Tejesh-ECM/Automated-Pill-Dispenser/ATTRIBUTION.md

# Sources and attribution

Based on MakersUPV, Smart Pill Dispenser: https://www.hackster.io/makersupv/smart-pill-dispenser-07a43f

Original and adapted mechanical materials retain Creative Commons Attribution NonCommercial 4.0 terms: https://creativecommons.org/licenses/by-nc/4.0/ . The source assembly STEP is preserved in mechanical/original_sources. Extracted parts are in mechanical/reference_parts, and experimental rotor adaptations are in mechanical/pill_candidates. The rotor adaptations replace the original Rueda edge opening while retaining its central geometry. These changes have not been endorsed by the original authors.

The desktop app, Arduino firmware, calibration helper, engineering drawings and build documentation in this redesign were created for this project. Third-party Arduino and Python libraries retain their respective licences and are installed separately, not relicensed by this package. Pinning a dependency version is a reproducibility choice, not a claim that the library author verified this dispenser.

Use the budget revision's docs/WIRING.md and docs/ACCEPTANCE_TESTS.md for current assignments and limitations. The original assembly is a source reference, not the final budget assembly.
