Tejesh-ECM/Automated-Pill-Dispenser/mechanical/budget_candidates/shared_refill_guard.stl

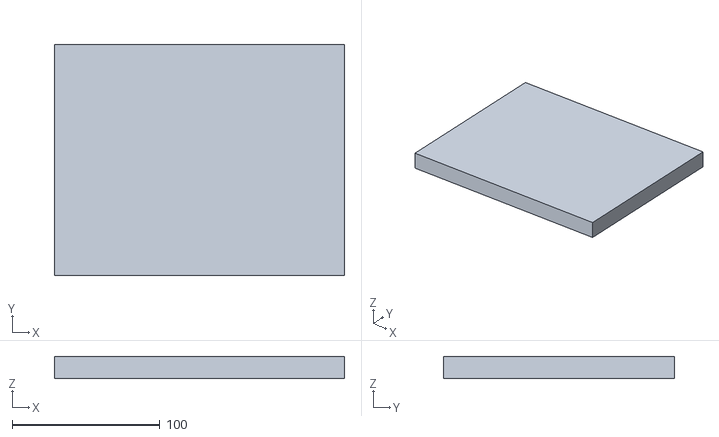
[picture p1: CAD file, 2026-10-11]
mechanical/budget_candidates/shared_refill_guard.stl
196.0 x 156.0 x 15.0
