Tejesh-ECM/Automated-Pill-Dispenser/mechanical/pill_candidates/C4_capsule_rotor.step

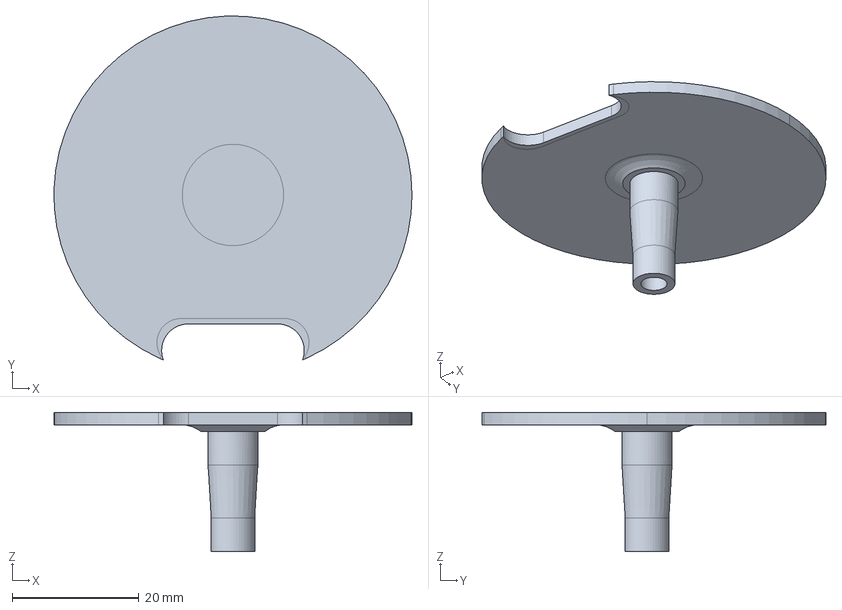
[picture p2: CAD file, 2026-10-11]
mechanical/pill_candidates/C4_capsule_rotor.step
56.5 x 54.3 x 22.0 mm
