Tejesh-ECM/Automated-Pill-Dispenser/mechanical/reference_parts/SmartPill_Drawings_v4_Slider_Slider_End.step

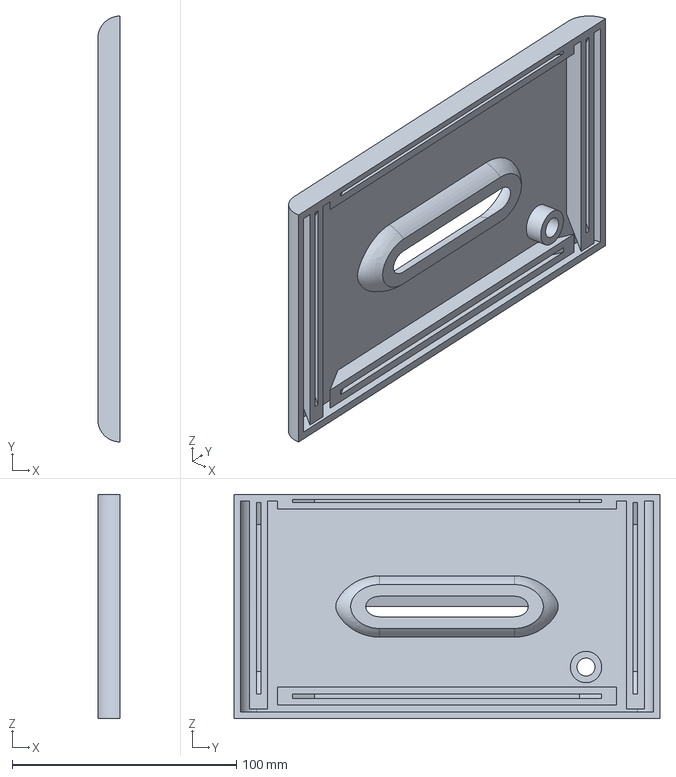
[picture p3: CAD file, 2026-10-11]
mechanical/reference_parts/SmartPill_Drawings_v4_Slider_Slider_End.step
10.0 x 190.0 x 100.0 mm
