Tejesh-ECM/Automated-Pill-Dispenser/mechanical/budget_candidates/lcd_16x2_plate.stl

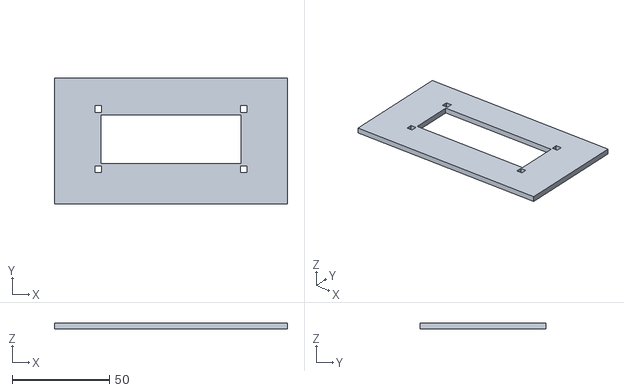
[picture p4: CAD file, 2026-10-11]
mechanical/budget_candidates/lcd_16x2_plate.stl
120.0 x 65.0 x 3.00
