Tejesh-ECM/Automated-Pill-Dispenser/mechanical/pill_candidates/C2_large_round_rotor.step

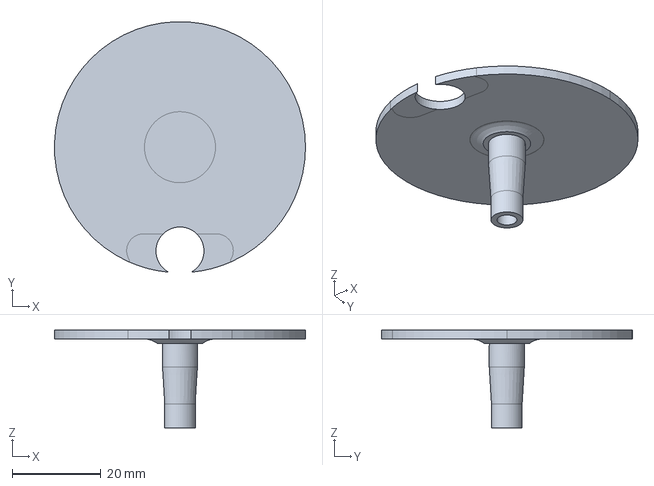
[picture p5: CAD file, 2026-10-11]
mechanical/pill_candidates/C2_large_round_rotor.step
56.5 x 56.4 x 22.0 mm
