Tejesh-ECM/Automated-Pill-Dispenser/mechanical/reference_parts/SmartPill_Drawings_v4_Back_Door.step

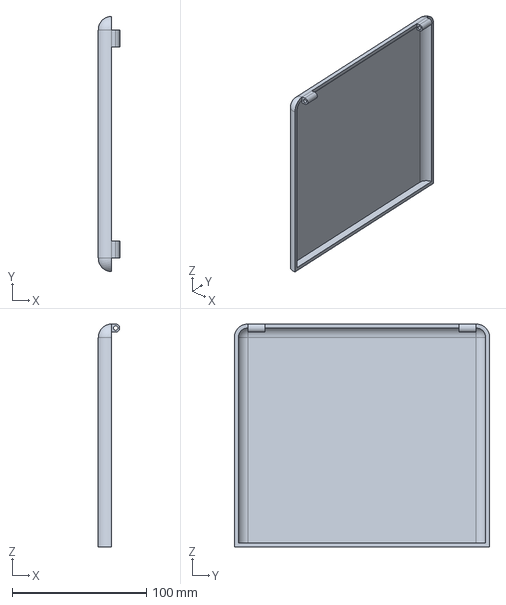
[picture p6: CAD file, 2026-10-11]
mechanical/reference_parts/SmartPill_Drawings_v4_Back_Door.step
16.0 x 190.0 x 165.9 mm
