Tejesh-ECM/Automated-Pill-Dispenser/mechanical/budget_candidates/fixed_receiving_tray.stl

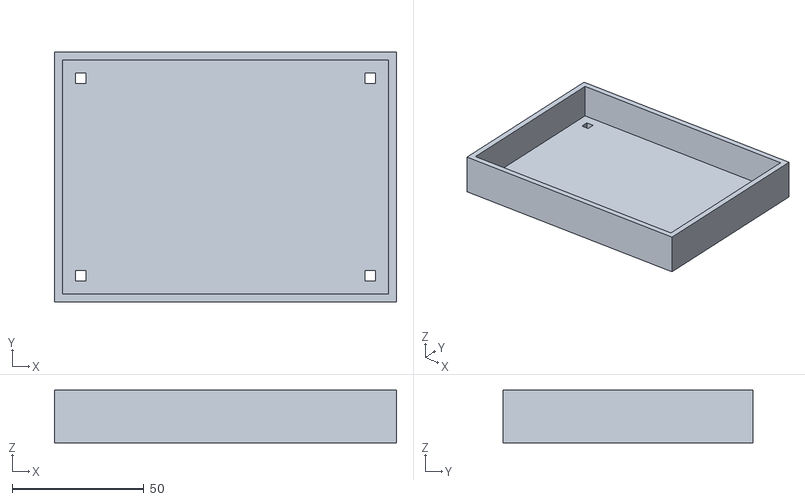
[picture p7: CAD file, 2026-10-11]
mechanical/budget_candidates/fixed_receiving_tray.stl
130.0 x 95.0 x 20.0
