Tejesh-ECM/Automated-Pill-Dispenser/mechanical/reference_parts/SmartPill_Drawings_v4_Slider_Slider_bottom.step

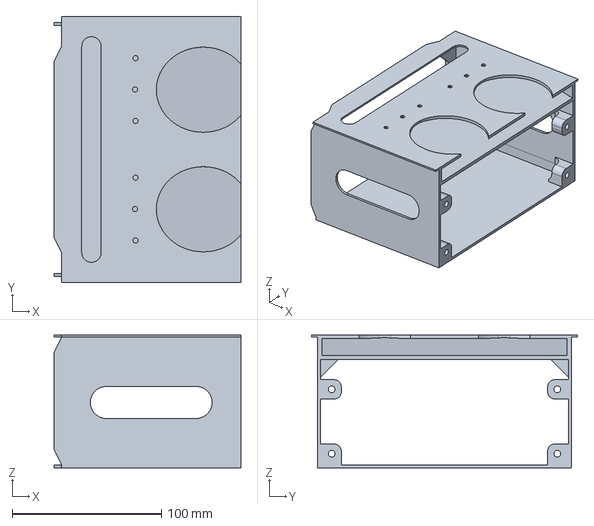
[picture p9: CAD file, 2026-10-11]
mechanical/reference_parts/SmartPill_Drawings_v4_Slider_Slider_bottom.step
125.0 x 178.0 x 88.8 mm
