Tejesh-ECM/Automated-Pill-Dispenser/mechanical/budget_candidates/manual_refill_plate.stl

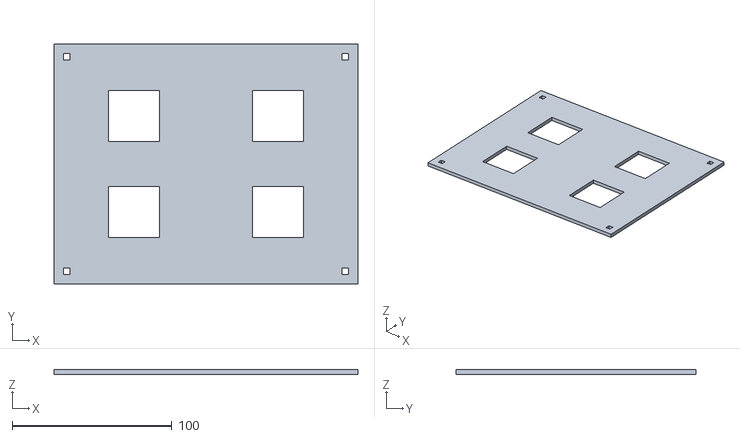
[picture p10: CAD file, 2026-10-11]
mechanical/budget_candidates/manual_refill_plate.stl
190.0 x 150.0 x 3.00
