Tejesh-ECM/Automated-Pill-Dispenser/mechanical/pill_candidates/C4_capsule_clearance_coupon.step

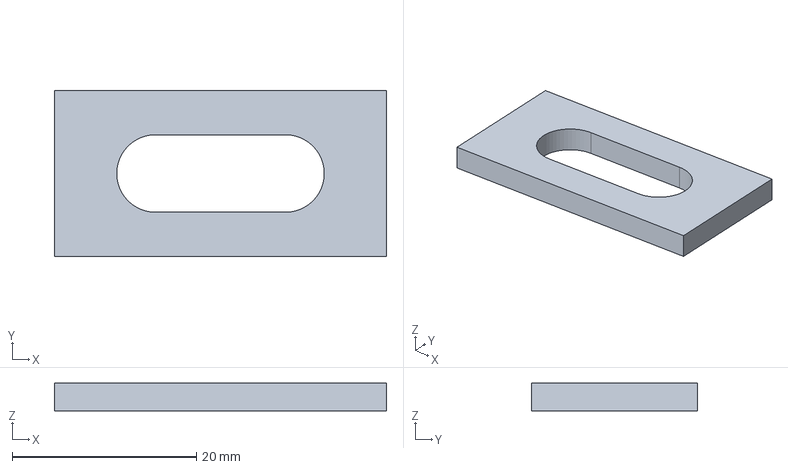
[picture p11: CAD file, 2026-10-11]
mechanical/pill_candidates/C4_capsule_clearance_coupon.step
36.0 x 18.0 x 3.00 mm
