Tejesh-ECM/Automated-Pill-Dispenser/mechanical/reference_parts/SmartPill_Drawings_v4_Dispensers_Dispenser_v9_Servo_Housing_Body1.step

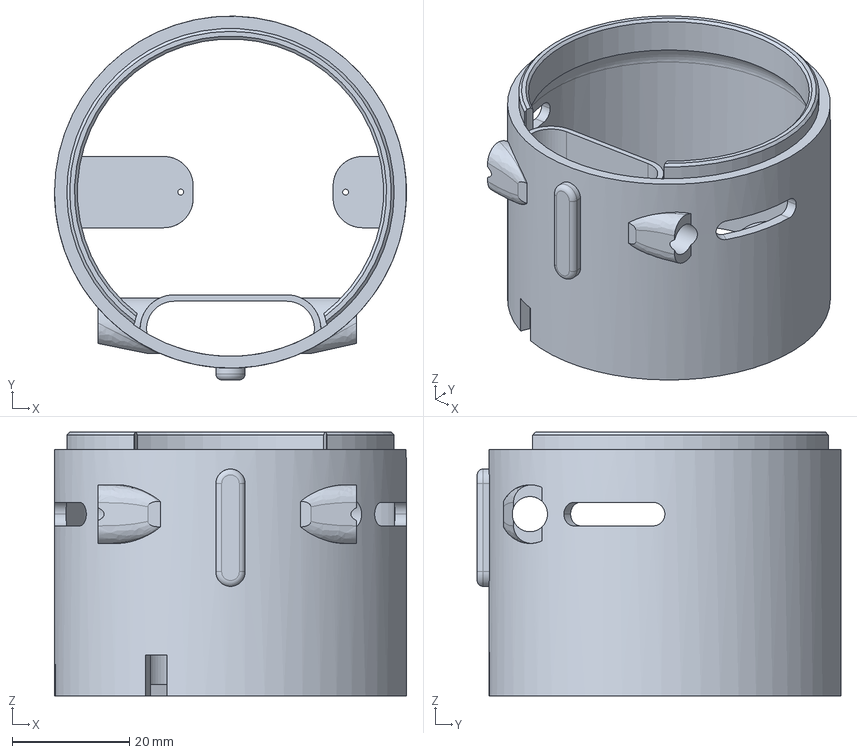
[picture p12: CAD file, 2026-10-11]
mechanical/reference_parts/SmartPill_Drawings_v4_Dispensers_Dispenser_v9_Servo_Housing_Body1.step
60.0 x 62.0 x 45.0 mm
