Tejesh-ECM/Automated-Pill-Dispenser/mechanical/budget_candidates/cover_switch_bracket.stl

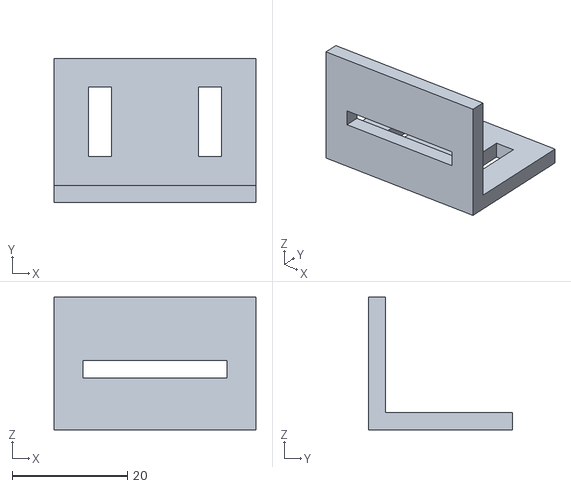
[picture p13: CAD file, 2026-10-11]
mechanical/budget_candidates/cover_switch_bracket.stl
35.0 x 25.0 x 23.0
