Tejesh-ECM/Automated-Pill-Dispenser/mechanical/pill_candidates/C1_small_round_rotor.step

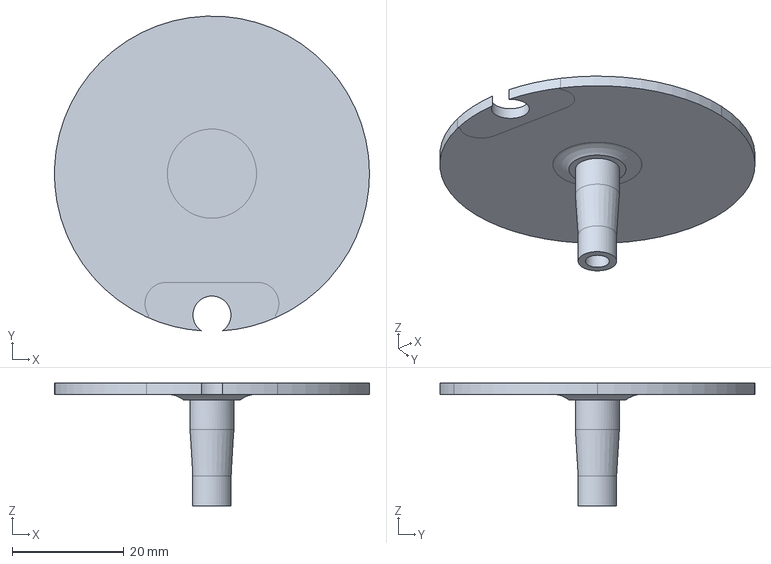
[picture p14: CAD file, 2026-10-11]
mechanical/pill_candidates/C1_small_round_rotor.step
56.5 x 56.4 x 22.0 mm
