Tejesh-ECM/Automated-Pill-Dispenser/mechanical/reference_parts/SmartPill_Drawings_v4_Drum.step

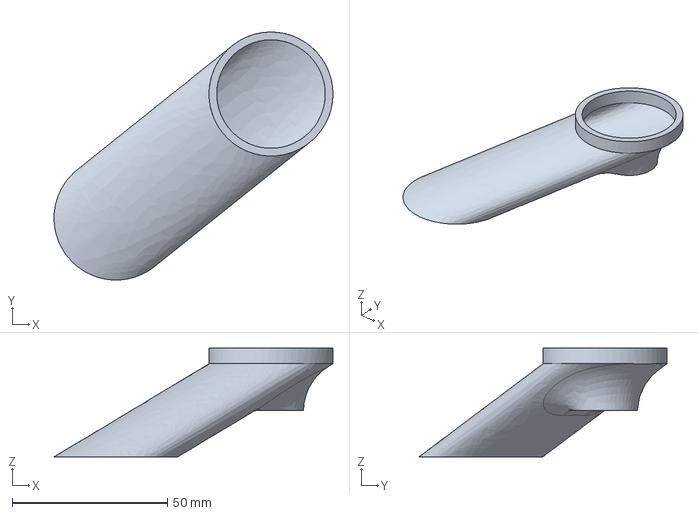
[picture p15: CAD file, 2026-10-11]
mechanical/reference_parts/SmartPill_Drawings_v4_Drum.step
90.0 x 80.0 x 35.0 mm
