Tejesh-ECM/Automated-Pill-Dispenser/mechanical/budget_candidates/refill_cap_print_four.stl

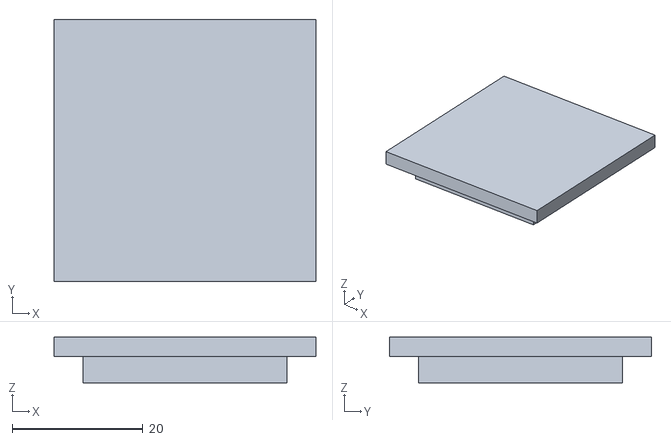
[picture p16: CAD file, 2026-10-11]
mechanical/budget_candidates/refill_cap_print_four.stl
40.0 x 40.0 x 7.00
