Tejesh-ECM/Automated-Pill-Dispenser/mechanical/pill_candidates/C1_small_round_dummy.step

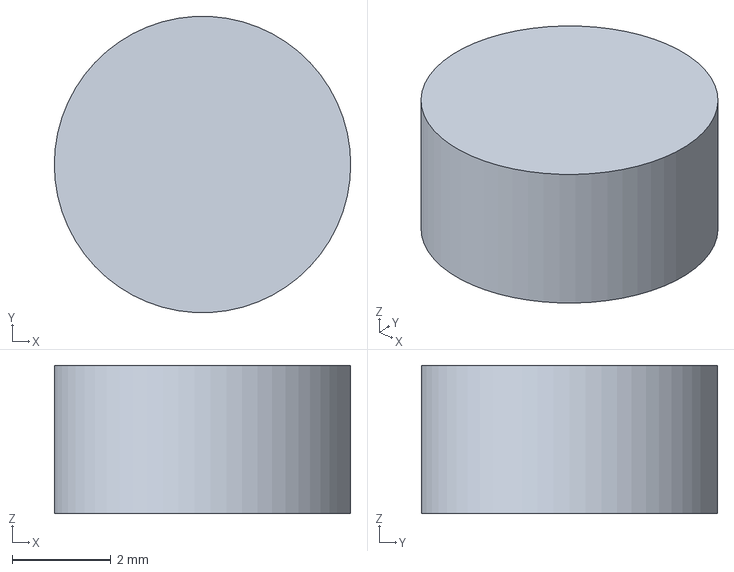
[picture p17: CAD file, 2026-10-11]
mechanical/pill_candidates/C1_small_round_dummy.step
6.00 x 5.99 x 3.00 mm
