Tejesh-ECM/Automated-Pill-Dispenser/mechanical/reference_parts/SmartPill_Drawings_v4_Dispensers_Dispenser_Base.step

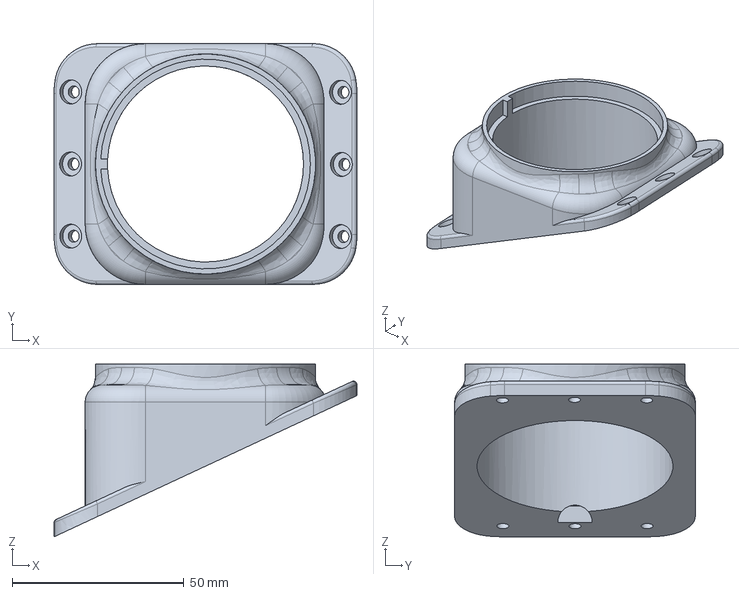
[picture p18: CAD file, 2026-10-11]
mechanical/reference_parts/SmartPill_Drawings_v4_Dispensers_Dispenser_Base.step
88.1 x 70.0 x 50.2 mm
