Tejesh-ECM/Automated-Pill-Dispenser/mechanical/budget_candidates/controller_plate.stl

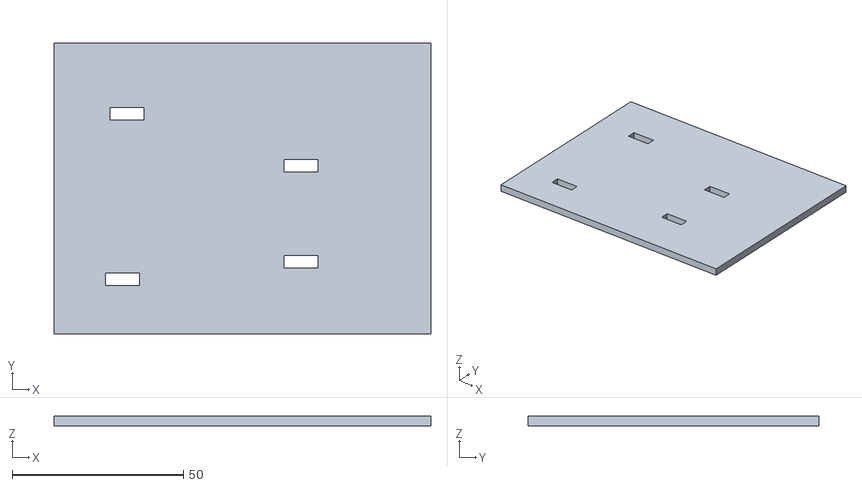
[picture p19: CAD file, 2026-10-11]
mechanical/budget_candidates/controller_plate.stl
110.0 x 85.0 x 3.00
