Tejesh-ECM/Automated-Pill-Dispenser/mechanical/pill_candidates/C3_oblong_dummy.step

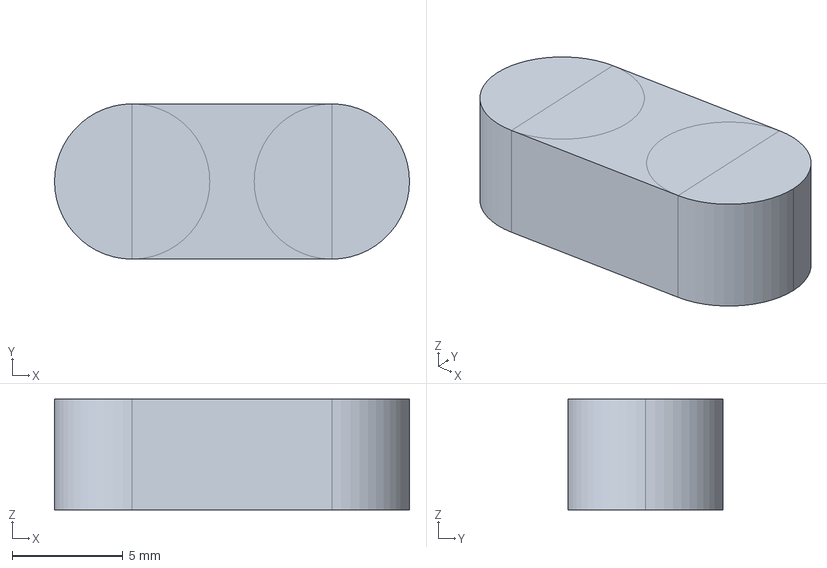
[picture p20: CAD file, 2026-10-11]
mechanical/pill_candidates/C3_oblong_dummy.step
16.0 x 7.00 x 5.00 mm
