Tejesh-ECM/Automated-Pill-Dispenser/mechanical/reference_parts/SmartPill_Drawings_v4_Mid_Display_holder.step

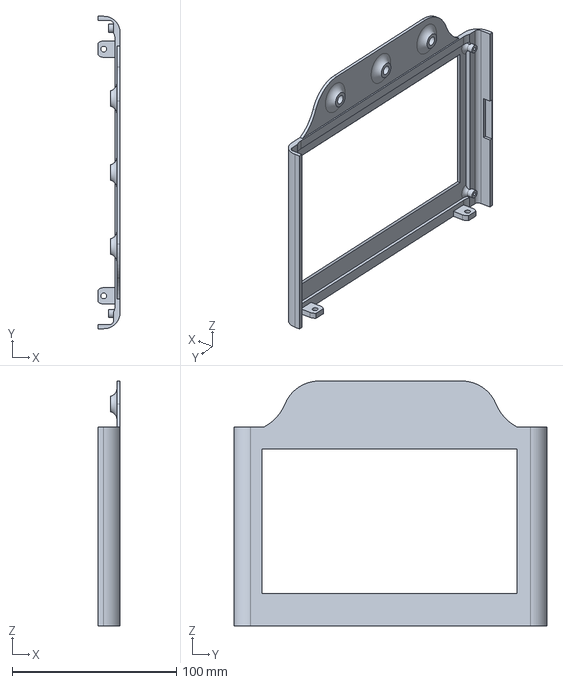
[picture p21: CAD file, 2026-10-11]
mechanical/reference_parts/SmartPill_Drawings_v4_Mid_Display_holder.step
13.6 x 190.0 x 148.9 mm
