Tejesh-ECM/Automated-Pill-Dispenser/mechanical/budget_candidates/refill_led_tab_print_four.stl

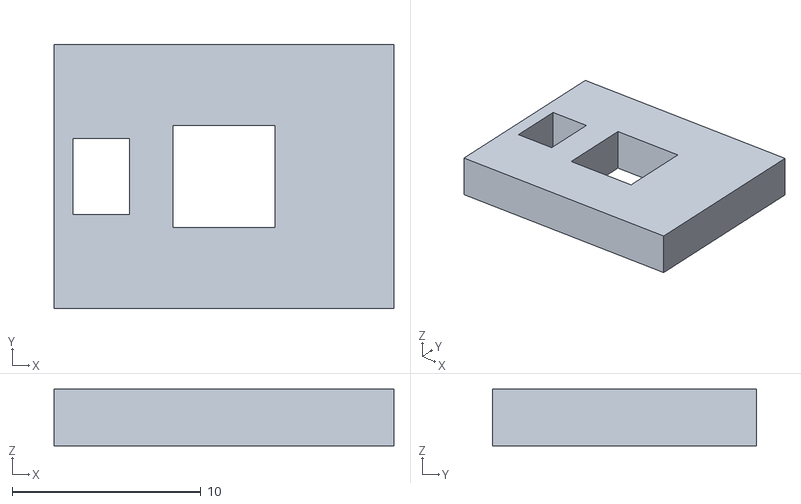
[picture p22: CAD file, 2026-10-11]
mechanical/budget_candidates/refill_led_tab_print_four.stl
18.0 x 14.0 x 3.00
