Tejesh-ECM/Automated-Pill-Dispenser/mechanical/reference_parts/SmartPill_Drawings_v4_Dispensers_Dispenser_v9_Cuenco.step

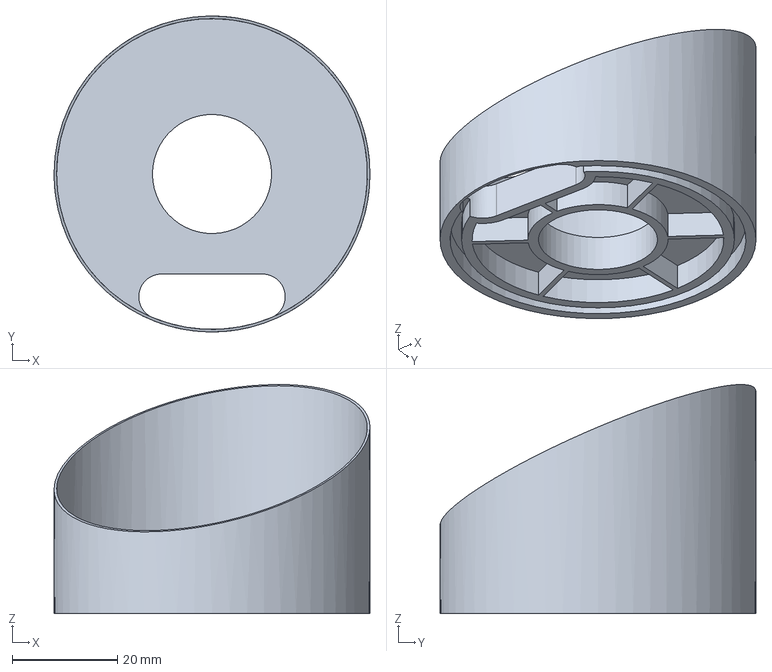
[picture p23: CAD file, 2026-10-11]
mechanical/reference_parts/SmartPill_Drawings_v4_Dispensers_Dispenser_v9_Cuenco.step
60.0 x 60.0 x 43.5 mm
