Tejesh-ECM/Automated-Pill-Dispenser/mechanical/pill_candidates/C2_large_round_dummy.step

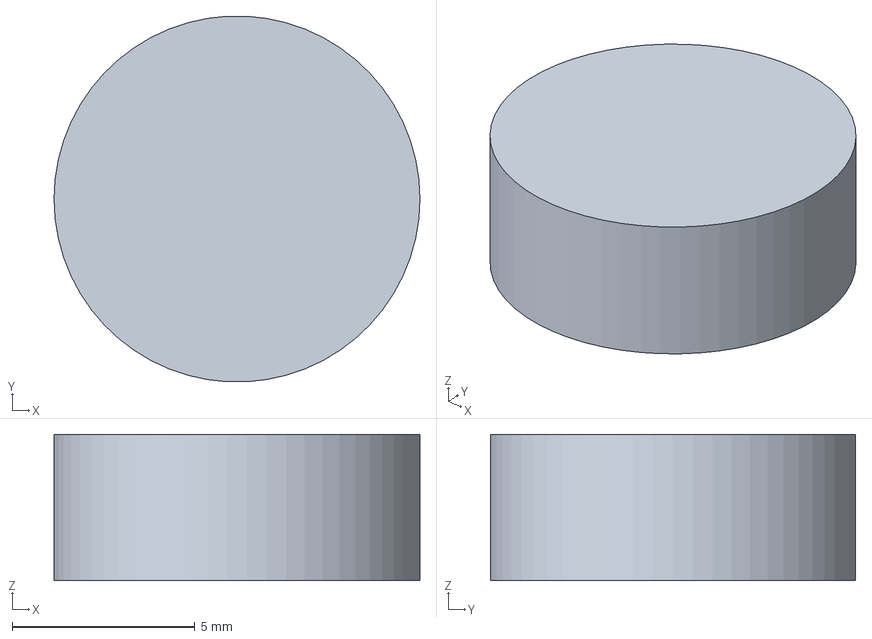
[picture p24: CAD file, 2026-10-11]
mechanical/pill_candidates/C2_large_round_dummy.step
10.0 x 9.99 x 4.00 mm
