Tejesh-ECM/Automated-Pill-Dispenser/mechanical/pill_candidates/C3_oblong_rotor.step

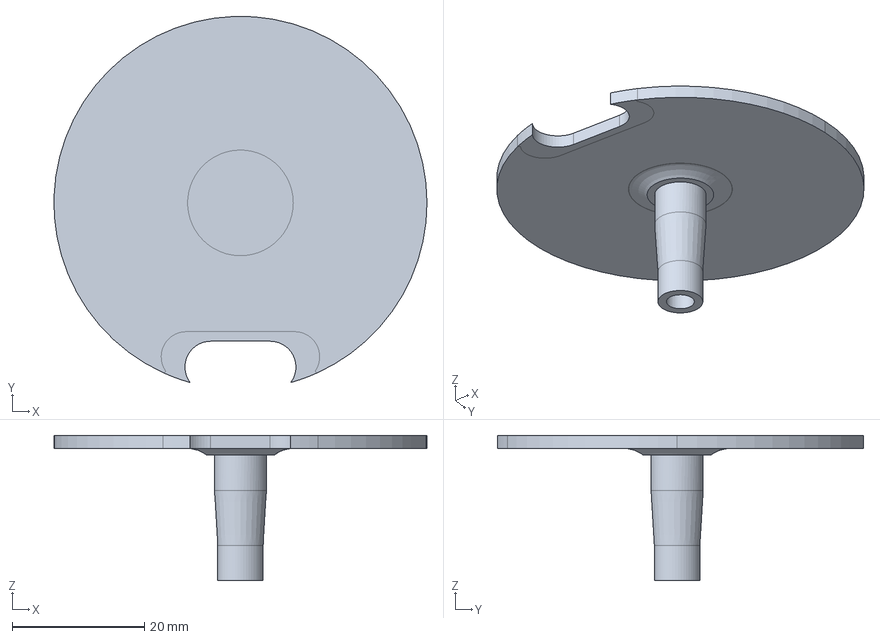
[picture p26: CAD file, 2026-10-11]
mechanical/pill_candidates/C3_oblong_rotor.step
56.5 x 55.4 x 22.0 mm
