Tejesh-ECM/Automated-Pill-Dispenser/mechanical/reference_parts/SmartPill_Drawings_v4_Base.step

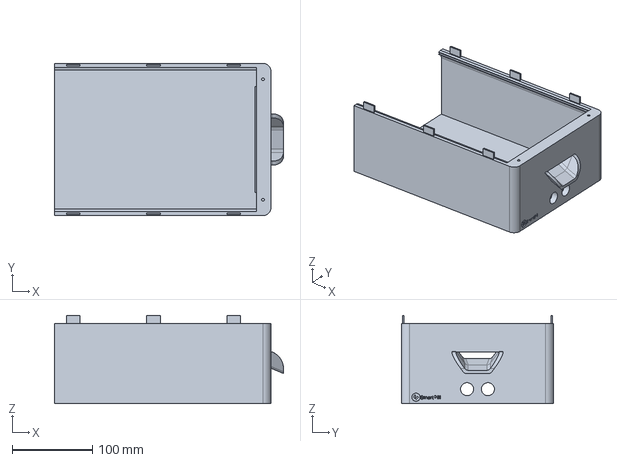
[picture p27: CAD file, 2026-10-11]
mechanical/reference_parts/SmartPill_Drawings_v4_Base.step
285.6 x 190.0 x 110.0 mm
