Tejesh-ECM/Automated-Pill-Dispenser/mechanical/pill_candidates/C1_small_round_clearance_coupon.step

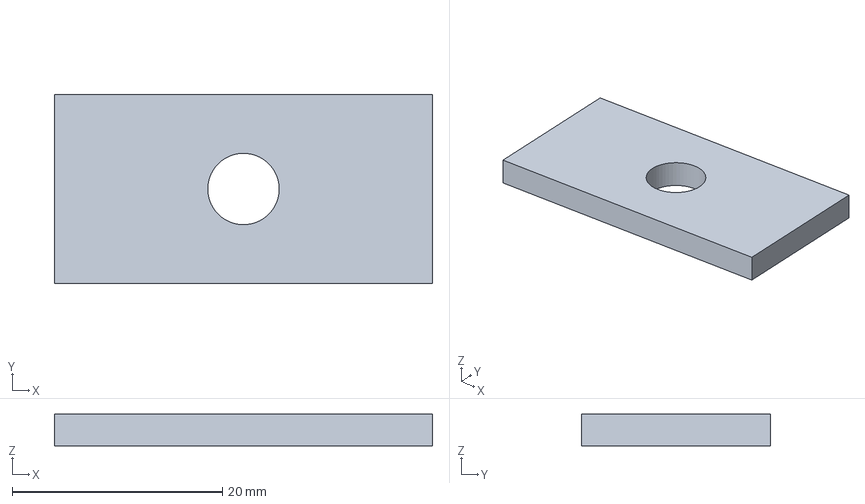
[picture p28: CAD file, 2026-10-11]
mechanical/pill_candidates/C1_small_round_clearance_coupon.step
36.0 x 18.0 x 3.00 mm
