Tejesh-ECM/Automated-Pill-Dispenser/mechanical/reference_parts/SmartPill_Drawings_v4_Mid_Right_Wall.step

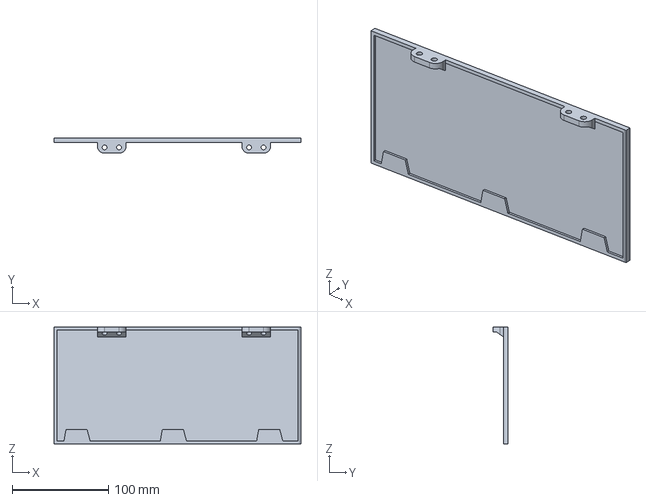
[picture p29: CAD file, 2026-10-11]
mechanical/reference_parts/SmartPill_Drawings_v4_Mid_Right_Wall.step
256.4 x 16.0 x 120.9 mm
