Tejesh-ECM/Automated-Pill-Dispenser/mechanical/pill_candidates/C4_capsule_dummy.step

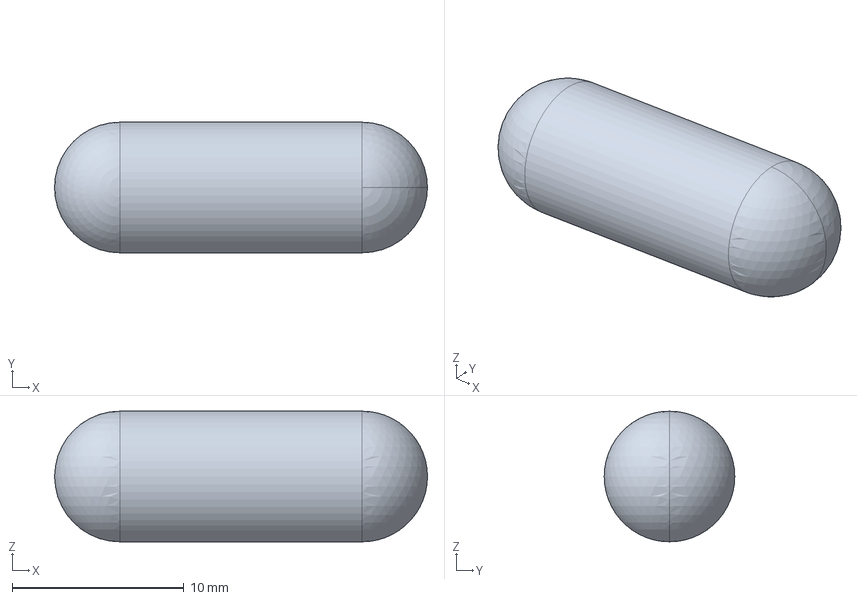
[picture p30: CAD file, 2026-10-11]
mechanical/pill_candidates/C4_capsule_dummy.step
21.7 x 7.60 x 7.60 mm
