Tejesh-ECM/Automated-Pill-Dispenser/mechanical/reference_parts/SmartPill_Drawings_v4_Top_Top_cover.step

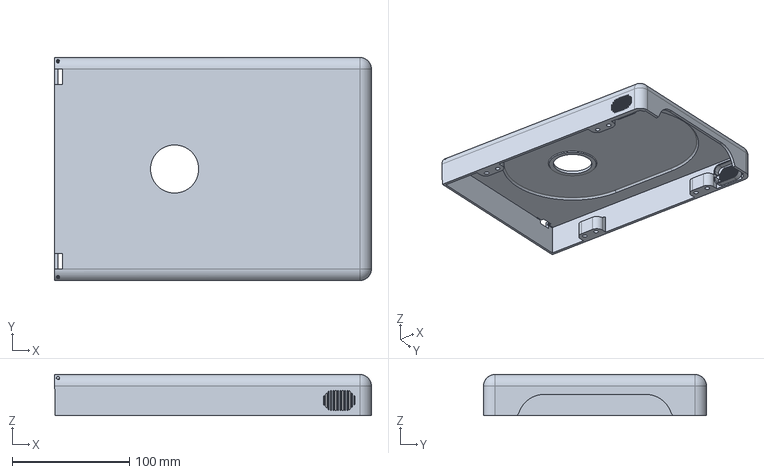
[picture p32: CAD file, 2026-10-11]
mechanical/reference_parts/SmartPill_Drawings_v4_Top_Top_cover.step
270.0 x 190.0 x 35.0 mm
