Tejesh-ECM/Automated-Pill-Dispenser/mechanical/reference_parts/SmartPill_Drawings_v4_Dispensers_Dispenser_v9_Servo_Housing_Body6.step

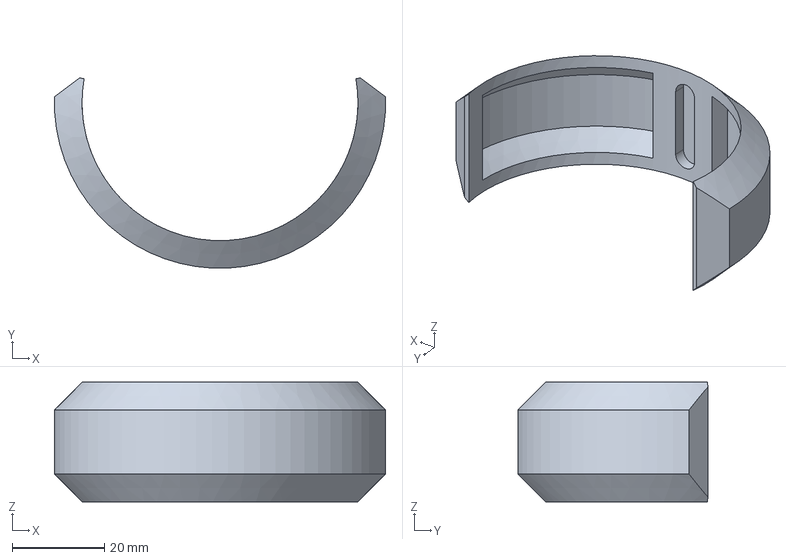
[picture p33: CAD file, 2026-10-11]
mechanical/reference_parts/SmartPill_Drawings_v4_Dispensers_Dispenser_v9_Servo_Housing_Body6.step
72.0 x 41.3 x 26.0 mm
