Tejesh-ECM/Automated-Pill-Dispenser/mechanical/budget_candidates/controller_plate.scad

// TEMPLATE ONLY. Measure and edit before printing. Millimetres.
difference(){union(){
translate([0, 0, 0]) cube([110, 85, 3]);
}
translate([15, 14.2, -1]) cube([10, 3.6000000000000014, 5]);
translate([16.3, 62.5, -1]) cube([10.0, 3.5999999999999943, 5]);
translate([67.1, 19.3, -1]) cube([10.0, 3.6000000000000014, 5]);
translate([67.1, 47.300000000000004, -1]) cube([10.0, 3.5999999999999943, 5]);
}
