Tejesh-ECM/Automated-Pill-Dispenser/mechanical/budget_candidates/cover_switch_bracket.scad

// TEMPLATE ONLY. Measure and edit before printing. Millimetres.
difference(){union(){
translate([0, 0, 0]) cube([35, 25, 3]);
translate([0, 0, 3]) cube([35, 3, 20]);
}
translate([6, 8, -1]) cube([4, 12, 5]);
translate([25, 8, -1]) cube([4, 12, 5]);
translate([5, -1, 9]) cube([25, 5, 3]);
}
