Tejesh-ECM/Automated-Pill-Dispenser/mechanical/budget_candidates/fixed_receiving_tray.scad

// TEMPLATE ONLY. Measure and edit before printing. Millimetres.
difference(){union(){
translate([0, 0, 0]) cube([130, 95, 20]);
}
translate([3, 3, 3]) cube([124, 89, 18]);
translate([8, 8, -1]) cube([4, 4, 4.1]);
translate([118, 8, -1]) cube([4, 4, 4.1]);
translate([8, 83, -1]) cube([4, 4, 4.1]);
translate([118, 83, -1]) cube([4, 4, 4.1]);
}
