Tejesh-ECM/Automated-Pill-Dispenser/mechanical/budget_candidates/lcd_16x2_plate.scad

// TEMPLATE ONLY. Measure and edit before printing. Millimetres.
difference(){union(){
translate([0, 0, 0]) cube([120, 65, 3]);
}
translate([24, 21, -1]) cube([72, 25, 5]);
translate([20.8, 16.3, -1]) cube([3.3999999999999986, 3.3999999999999986, 5]);
translate([95.8, 16.3, -1]) cube([3.4000000000000057, 3.3999999999999986, 5]);
translate([20.8, 47.3, -1]) cube([3.3999999999999986, 3.4000000000000057, 5]);
translate([95.8, 47.3, -1]) cube([3.4000000000000057, 3.4000000000000057, 5]);
}
