Tejesh-ECM/Automated-Pill-Dispenser/mechanical/budget_candidates/manual_refill_plate.scad

// TEMPLATE ONLY. Measure and edit before printing. Millimetres.
difference(){union(){
translate([0, 0, 0]) cube([190, 150, 3]);
}
translate([34, 29, -1]) cube([32, 32, 5]);
translate([124, 29, -1]) cube([32, 32, 5]);
translate([34, 89, -1]) cube([32, 32, 5]);
translate([124, 89, -1]) cube([32, 32, 5]);
translate([6, 6, -1]) cube([4, 4, 5]);
translate([180, 6, -1]) cube([4, 4, 5]);
translate([6, 140, -1]) cube([4, 4, 5]);
translate([180, 140, -1]) cube([4, 4, 5]);
}
