Tejesh-ECM/Automated-Pill-Dispenser/mechanical/budget_candidates/refill_cap_print_four.scad

// TEMPLATE ONLY. Measure and edit before printing. Millimetres.
difference(){union(){
translate([0, 0, 0]) cube([40, 40, 3]);
translate([4.4, 4.4, -4]) cube([31.200000000000003, 31.200000000000003, 4]);
}

}
