Tejesh-ECM/Automated-Pill-Dispenser/mechanical/budget_candidates/refill_led_tab_print_four.scad

// TEMPLATE ONLY. Measure and edit before printing. Millimetres.
difference(){union(){
translate([0, 0, 0]) cube([18, 14, 3]);
}
translate([6.3, 4.3, -1]) cube([5.3999999999999995, 5.3999999999999995, 5]);
translate([1, 5, -1]) cube([3, 4, 5]);
}
