Tejesh-ECM/Automated-Pill-Dispenser/(list of files, cad)

Other CAD files:
mechanical/pill_candidates/C3_oblong_clearance_coupon.step
mechanical/reference_parts/SmartPill_Drawings_v4_Dispensers_Dispenser_v9_Rueda.step
mechanical/budget_candidates/shared_refill_guard.scad
mechanical/pill_candidates/C1_small_round_clearance_coupon.stl
mechanical/pill_candidates/C1_small_round_dummy.stl
mechanical/pill_candidates/C1_small_round_rotor.stl
mechanical/pill_candidates/C2_large_round_clearance_coupon.stl
mechanical/pill_candidates/C2_large_round_dummy.stl
mechanical/pill_candidates/C2_large_round_rotor.stl
mechanical/pill_candidates/C3_oblong_clearance_coupon.stl
mechanical/pill_candidates/C3_oblong_dummy.stl
mechanical/pill_candidates/C3_oblong_rotor.stl
mechanical/pill_candidates/C4_capsule_clearance_coupon.stl
mechanical/pill_candidates/C4_capsule_dummy.stl
mechanical/pill_candidates/C4_capsule_rotor.stl
mechanical/reference_parts/SmartPill_Drawings_v4_Back_Door.stl
mechanical/reference_parts/SmartPill_Drawings_v4_Base.stl
mechanical/reference_parts/SmartPill_Drawings_v4_Dispensers_Dispenser_Base.stl
mechanical/reference_parts/SmartPill_Drawings_v4_Dispensers_Dispenser_v9_Cuenco.stl
mechanical/reference_parts/SmartPill_Drawings_v4_Dispensers_Dispenser_v9_Rueda.stl
mechanical/reference_parts/SmartPill_Drawings_v4_Dispensers_Dispenser_v9_Servo_Housing_Body1.stl
mechanical/reference_parts/SmartPill_Drawings_v4_Dispensers_Dispenser_v9_Servo_Housing_Body6.stl
mechanical/reference_parts/SmartPill_Drawings_v4_Drum.stl
mechanical/reference_parts/SmartPill_Drawings_v4_Mid_Display_holder.stl
mechanical/reference_parts/SmartPill_Drawings_v4_Mid_Left_Wall.stl
mechanical/reference_parts/SmartPill_Drawings_v4_Mid_Right_Wall.stl
mechanical/reference_parts/SmartPill_Drawings_v4_Slider_Slider_End.stl
mechanical/reference_parts/SmartPill_Drawings_v4_Slider_Slider_Face.stl
mechanical/reference_parts/SmartPill_Drawings_v4_Slider_Slider_bottom.stl
mechanical/reference_parts/SmartPill_Drawings_v4_Top_Top_base.stl
mechanical/reference_parts/SmartPill_Drawings_v4_Top_Top_cover.stl
