Tejesh-ECM/Automated-Pill-Dispenser/SmartPill_Complete_Audited_Guide.docx

# SmartPill Complete Project Guide

Audited budget revision with guided refill LEDs

UNO R4 Minima or UNO R4 WiFi • Protocol 4 • Chennai cost planning • 9 October 2026

Four containers dispense whole test pieces at three saved daily times. The computer sets labels, quantities and times through USB. The controller then runs the schedule independently while external power remains connected.

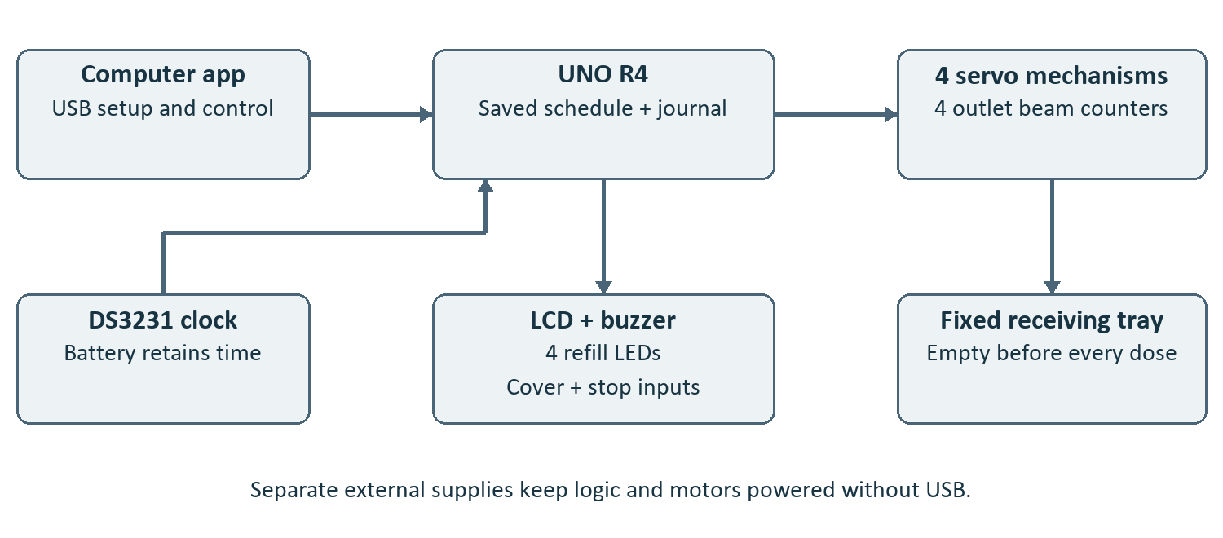
[picture p35: figure]

## Current project status

Firmware, desktop software, candidate CAD and instructions are supplied. This audit corrected software defects and passed the checks described on page 14. No physical board or assembled dispenser was connected during the audit. CAD fit, pill separation, servo torque, optical accuracy and power interruption behaviour still need bench testing.

Use inert objects during development. The shipped configuration keeps normal dispensing disabled until commissioning. This is a supervised college prototype, not a validated medication delivery device.

## Budget at a glance

Electronics allowance: ₹5,594. With ₹500–1,000 delivery and ₹1,000 reserve: ₹7,094–7,594. A practical electronics budget is about ₹7,500–8,000. Printing, mechanical hardware, liner, tools, computer and labour are additional.

## Guide map

2 Features • 3 Daily operation • 4 Refill • 5 Structures • 6 Pin map • 7 Circuits and power • 8–9 Materials and costs • 10 Assembly • 11 Software setup • 12 Acceptance tests • 13 Faults • 14 Audit • 15 Files and references

# Features and their exact behaviour

Feature | What it does and its limits
Four independent containers | Each holds one labelled type. A separate positional servo and optical outlet channel serve each container. Containers dispense sequentially.
Three daily periods | Three distinct times; each period has four quantities from 0 to 10 whole pieces. A zero quantity skips that container. Names are labels, not identification.
Computer independent schedule | Settings and daily claims live in internal data flash. A DS3231 supplies time. USB is unnecessary for scheduled dispensing after setup; both external supplies remain on.
No duplicate automatic replay | A date claim is committed before motion. Already claimed periods do not repeat on the same or an earlier date. Late or inhibited periods are skipped; there is no automatic catch-up.
Optical counting | Four conditioned IR beams count complete beam interruptions. Unexpected outlet activity, excess counts, blockage and timeouts latch faults. Two touching pieces may still look like one event.
16 by 2 LCD | Shows date/time, next configured time, disabled state, selected refill label/number, count progress and a shortened fault. Read the software for longer detail.
Buzzer | Three short beeps at dose start, two on completion and five on fault. It is a passive piezo with a transistor driver.
Wired computer app | Connect, set local clock, edit/read/save settings, enable controls, view LCD/result, select refill LED, request an extra manual dose, stop and clear an inspected fault.
Selected refill LED | Exactly one of four LEDs lights after a valid connected-software selection. All others stay off. It does not detect medicine, level or successful filling.
Cover and physical stop | Open cover inhibits refill-time motion; opening it during motion faults. A separate stop contact cuts motor power and another contact signals the controller.
Fault recovery and storage | An unfinished recorded job requires inspection after restart. CRC-checked snapshots rotate across eight 1 KB pages. Torn storage is not silently accepted.
Limited result record | The latest device outcome survives offline. Connected result snapshots are logged on the computer. Neither collection nor medicine intake is confirmed.

No inventory, remaining-pill estimate, prescription calculation, automatic refill confirmation or full offline event history is implemented. The simple design does not infer these from optical counts.

# Daily operation and scheduling

## Before each scheduled dose

1. Check that the physical container labels match the saved software labels and that the saved quantities are correct.

2. Empty the fixed tray and fit its cleanable liner. A later dose will join any pieces left there; the machine cannot detect this.

3. Close every refill cap and the shared cover. Release the physical stop. Confirm the LCD shows enabled operation and the correct local clock.

4. Keep the 9 V logic adapter and 5 V motor adapter powered. The computer can be unplugged after setup.

## What happens at a due time

After startup settles, the scheduler checks the RTC about once per second. When a saved period is due and the device is ready, it saves that period’s date claim, then an active-job record, before attaching a servo. It drives the required containers one at a time and counts their outlet events.

At the requested count, the servo is commanded closed and held for 500 ms. It is then detached before proceeding. On success the active marker clears, DISPENSED is stored, the buzzer sounds twice and the unit returns to IDLE. The gate must stay physically closed without servo holding torque.

Situation | Result
Computer disconnected | Saved automatic schedules continue. Manual jobs depend on computer heartbeats and fault after the configured timeout.
Power completely lost | No dispensing occurs. The coin cell keeps only the clock running. An unfinished recorded job faults on restart.
Due time while busy, refilling or disabled | That period is skipped and claimed for the day. Closing the cover or finishing another job does not intentionally catch it up.
Power restored after a period’s minute | That period is missed. Restoration during the due minute may dispense if no prior claim exists and startup checks pass.
Manual dose requested | It is an EXTRA dose using the selected period’s saved quantities. It does not replace or consume the automatic period.
Clock moved backwards | A period already claimed for a date cannot repeat on that date or an earlier one. Check settings after any clock change.

The saved schedule checkbox and “Enable controls” serve different purposes: the checkbox enables automatic periods; controls must also be armed. Clearing a fault leaves controls disabled until explicitly enabled. Normal commissioned startup can arm automatically after checks pass.

# Guided refill procedure

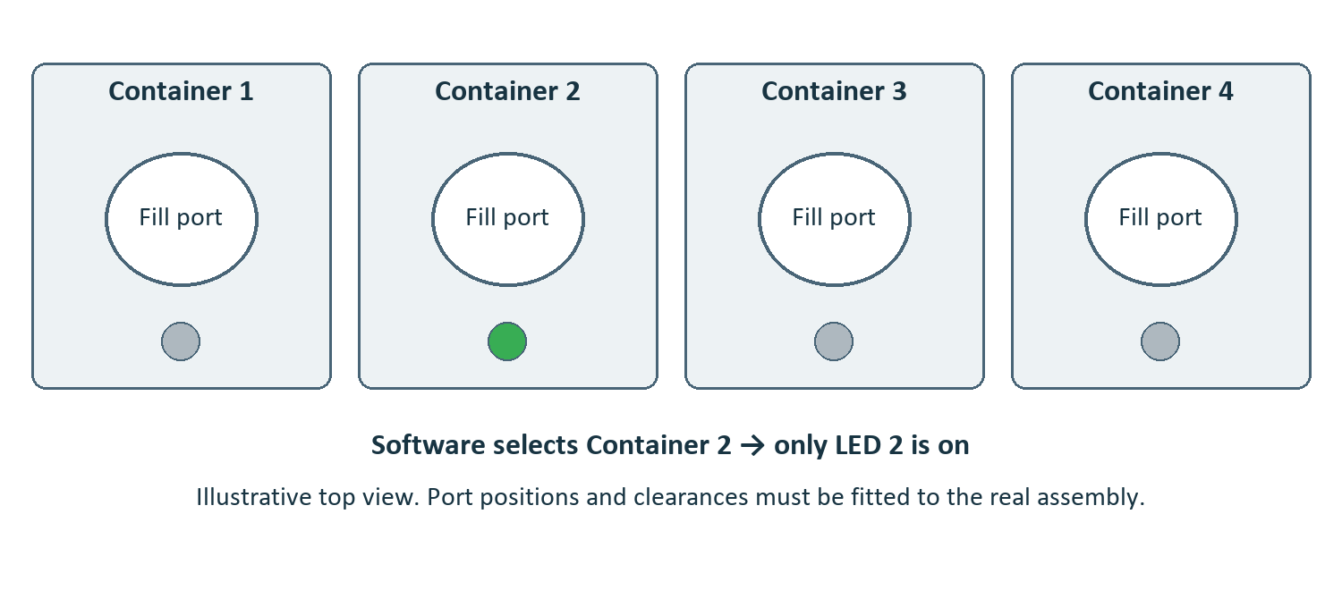
[picture p36: figure]

1. Wait for IDLE, plug in USB and connect the computer app. Read saved settings so container numbers and medicine labels are current.

2. Choose the required container in the Refill guide selector. Click “Light selected container” and wait for confirmation from the device. Only that container’s LED lights; the LCD shows its saved label and number.

3. Open the shared cover. Open only the selected container’s cap. Check the printed label against the intended contents, then fill without pressing pieces into the rotor or exceeding a physically tested fill level.

4. Close that cap. To refill another container, select it in software; the previous LED turns off before the new one turns on.

5. Close every cap and the shared cover. After one second of stable closure, refill mode ends and all LEDs switch off. “Finish refill” also works with the cover safely closed.

6. Check the tray for any stray pieces, inspect the LCD and verify the next scheduled time. A period missed during refill is not replayed.

## Meaning of the light

The LED means “this is the selected port to refill.” It stays lit during selection, including before medicine is added. The system cannot know whether that container was actually filled. Do not describe it as a refill-complete or pill-level sensor.

## If the computer connection is lost

LEDs clear when disconnect is detected, or within the five-second heartbeat timeout. An open cover continues to inhibit motion. Closing the app sends a cancellation when possible. With no USB connection, manual refill remains possible using the printed labels and cover interlock, without LED guidance.

Opening the cover during dispensing is a fault, not a normal refill request. Stop, inspect the tray and mechanism, and use the recovery procedure on page 13.

# Mechanical structure and CAD status

The proposed assembly has four original-style bowl/rotor dispensing mechanisms, four direct fill ports with caps, a shared guard, a fixed tray, a smaller LCD panel and an UNO mounting plate. LEDs mount beside the fixed ports, outside the pill paths; do not put wiring on removable caps.

Included structure | Status and work still required
Original bowl, rotor and motor housing references | Available in mechanical/reference_parts and the full STEP source. The original motor housing is labelled for TGY-9025MG; SG90 mounting and shaft fit are unverified.
Manual refill plate and four caps | Editable templates. Plate 190 × 150 × 3 mm; example 32 mm square ports at (50,45), (140,45), (50,105), (140,105) mm. These are not assembly-derived coordinates.
Shared guard and switch bracket | Templates need hinges/retention, clearances and switch travel fitted to the real assembly. Cover closure must be mechanically unambiguous.
LCD and controller plates | LCD plate 120 × 65 × 3 mm with a 72 × 25 mm window. Measure the purchased display, backpack and mounting holes before printing.
Fixed receiving tray | Candidate cradle/tray geometry; fit it under the real common outlet and verify maximum-dose capacity. Add a removable cleanable liner.
Four LED tabs | Print four: each template 18 × 14 × 3 mm with a 5.4 mm square aperture. Adapt LED retention and insulate exposed leads.

## Four test piece profiles

Container | Illustrative shape | Envelope in mm
1 | Small round tablet | 6 × 6 × 3
2 | Larger round tablet | 10 × 10 × 4
3 | Oblong tablet | 16 × 7 × 5
4 | Capsule shaped piece | 21.7 × 7.6 × 7.6

These are illustrative engineering test envelopes, not verified “most-used” pill sizes or a promise that all commercial pills fit. Measure actual length, width and thickness. Profile-shaped holes alone do not prevent stacked pieces or double feeds.

Eight new template meshes pass closure, orientation and volume checks. No complete assembled fit is proven. The original base is about 285.6 × 190 mm, beyond many 220 mm printer beds: use a suitable printer or engineer a split; do not scale the whole mechanism. Print one mechanism and fit coupons before committing all parts.

# Complete UNO R4 connection map

UNO R4 point | Connection | Important detail
USB-C | Computer data cable | Use a data cable; USB Serial is the app link.
Barrel jack | 9 V regulated adapter | Centre positive; 5.5 × 2.1 mm plug.
5 V logic rail | LCD, RTC, SN74HC14, optics, buzzer driver | Measure total load and regulator temperature.
A4 / SDA; A5 / SCL | LCD and DS3231 I2C bus | RTC 0x68; confirm LCD address before editing config.h.
D2; D3; D4; D5 | Servo signals 1; 2; 3; 4 | One 10 kΩ signal pull-down per servo.
D0; D1; D8; D12 | Conditioned optical outputs 1; 2; 3; 4 | Blocked must read LOW. Do not use Serial1.
A0; A1; A2; A3 | Refill LEDs 1; 2; 3; 4 | Each output → its own 1 kΩ resistor → LED anode.
D7 | Cover switch to GND | Closes only with cover fully fitted. INPUT_PULLUP.
D9 | Stop sense NC contact to GND | Released stop closes contact; stop/broken wire opens it.
D10 | 1 kΩ → buzzer transistor base | 10 kΩ from base to GND.
GND | Logic ground and motor negative | Join grounds at distribution; keep positive rails separate.

## Pin conflict corrected in this revision

A0–A3 are digital outputs for the four refill LEDs. They must not remain connected to raw phototransistor collector nodes. Keep those raw nodes only at the Schmitt inputs and insulated meter/scope pads. The actual digital beam signals stay on D0, D1, D8 and D12.

## Before applying power

- Use the correct board option: UNO R4 Minima for Minima, or UNO R4 WiFi for that board. The classic UNO R3 is not compatible with this build.
- Verify switch continuity in the real fitted/released positions; contact labels alone can be misleading.
- Do not run motor current through the UNO regulator, GPIO pins or a solderless breadboard.
- Keep logic and motor positives separate. Do not feed the motor adapter into the UNO 5 V pin or USB supply.

# Circuits and power distribution

## Optical channels and filtering

For each IR emitter: logic 5 V → initial 220 Ω resistor → emitter anode; cathode → GND. Check the purchased emitter current rating. Phototransistor emitter → GND; collector → raw node; 10 kΩ pulls the raw node to 5 V. The raw node feeds a Schmitt inverter.

SN74HC14N DIP14: pin 14 to 5 V, pin 7 to GND, 100 nF directly between them. Use input→output pairs 1→2, 3→4, 5→6 and 9→8 for channels 1–4. Tie unused inputs 11 and 13 to GND; leave outputs 10 and 12 open. Clear aligned beams should give HIGH at the UNO; blocked beams LOW. Shield paths from stray light and separate neighbouring channels.

## Refill LEDs and buzzer

A0–A3 each feed a separate 1 kΩ resistor and LED anode; each cathode returns to GND. Typical current is 2–3 mA; the 5 V/1 kΩ upper bound is 5 mA, below the R4 8 mA per-pin maximum. Never substitute the 220 Ω emitter resistor here.

Passive piezo positive → logic 5 V; negative → PN2222A collector; emitter → GND. Put a separate 1 kΩ discharge resistor across the piezo terminals (5 V to collector). D10 drives the base through another 1 kΩ, with a 10 kΩ base-to-GND pull-down. Check the actual transistor pin order. The discharge path is required for this capacitive piezo load; verify clear beeps on the bench.

## Two independent supplies

Motor path: enclosed regulated 5 V/5 A adapter → main fuse → adequately DC-rated normally closed stop power contact → four fused servo-positive branches. Each servo ground returns to the motor negative. Only one servo is commanded at a time, but all connected units may draw idle current.

Logic path: separate regulated 9 V/1 A adapter → UNO barrel jack. Common ground joins the systems; their positive outputs are not joined. Include a matching motor-adapter input socket in the harness allowance. The example motor plug is 5.5 × 2.5 mm, different from the UNO barrel size.

Initial fuse allowances are 5 A time-delay main and 2 A time-delay per branch. These are provisional: final values depend on measured inrush/stall current and the weakest wire, connector and contact rating. Starting wire sizes are 18 AWG trunk, 22 AWG motor branches and 24–26 AWG signals; verify drop and temperature.

Place the 1000 µF capacitor on the supply side of the stop contact. Use local 100 nF decoupling at the Schmitt IC and near sensor/LCD/RTC branches as needed. Keep wires short, insulated and strain relieved. The seven small capacitors are a purchasing allowance, not an instruction to fit unnecessary duplicates on already-decoupled modules.

## RTC battery and mechanical closure

Use a non-charging DS3231 breakout with a CR2032. Its battery powers only timekeeping. Detaching a servo or cutting power does not guarantee a closed gate: the mechanism itself must remain closed without holding torque. Exact stop selection, supply load and closure tests are required.

# Electronics materials and cost part one

Chennai planning estimate in INR, 9 October 2026. These are rounded allowances, not an order or guaranteed supplier quote. Quantities are for four containers. Only current installed electronics are listed.

Item | Qty | Each ₹ | Total ₹ | Use or purchasing check
UNO R4 Minima | 1 | 1000 | 1000 | Controller and internal schedule storage
16x2 LCD with I2C backpack | 1 | 250 | 250 | Clock, next time, status and faults
DS3231 module, non-charging battery circuit | 1 | 300 | 300 | Independent clock
CR2032 | 1 | 40 | 40 | Retains time during power loss
5 V-compatible SG90 positional servo | 4 | 150 | 600 | One per dispensing mechanism; verify torque
Matched IR emitter and phototransistor pair | 4 | 30 | 120 | Individual outlet counters
SN74HC14N DIP14 | 1 | 60 | 60 | Conditions optical signals
Passive piezo buzzer | 1 | 30 | 30 | Audible reminders and faults
PN2222A transistor | 1 | 10 | 10 | Buzzer driver
220 ohm resistors | 4 | 2 | 8 | Initial emitter current limiting
10 kohm resistors | 9 | 2 | 18 | 4 optical pull-ups, 4 servo signal pull-downs, 1 buzzer pull-down
1 kohm resistors | 6 | 2 | 12 | Buzzer base and piezo discharge resistors, plus four individual refill LED resistors
Diffused 5 mm green indicator LEDs | 4 | 5 | 20 | One beside each refill port; selected through USB software

The 1 kΩ quantity is six: four LED resistors, one buzzer base resistor and one resistor across the piezo for discharge. The nine 10 kΩ resistors are four optical pull-ups, four servo signal pull-downs and one buzzer base pull-down.

## Selection checks before buying

- Choose a genuine compatible UNO R4 board. An owned UNO R4 WiFi can run the matching build; the allowance assumes buying Minima.
- Buy an HD44780-compatible 16×2 character LCD with a compatible I2C backpack. Confirm the controller and address; supplier descriptions may be inconsistent.
- Buy positional servos, not continuous-rotation models. SG90 is a cost candidate only; check the actual unit’s 5 V rating, mounting, torque and reliable return to closure.
- Use matched IR emitter/phototransistor pairs with datasheets. Generic part names do not establish sensing distance or current ratings.

# Electronics materials and cost part two

Item | Qty | Each ₹ | Total ₹ | Use or purchasing check
100 nF capacitors | 7 | 3 | 21 | Decoupling allowance
1000 uF >=16 V electrolytic | 1 | 35 | 35 | Motor supply transient support, upstream of stop
Two-NC latching stop with adequate DC breaking capacity | 1 | 1000 | 1000 | Provisional allowance; exact rating/quote unresolved
Cover interlock microswitch and leads | 1 | 100 | 100 | Manual refill inhibit
Enclosed regulated 5 V 5 A adapter | 1 | 900 | 900 | Conditional on measured servo load test
9 V 1 A centre-positive 5.5x2.1 mm adapter | 1 | 250 | 250 | Independent UNO supply
Main fuse and holder | 1 | 80 | 80 | Initial 5 A time-delay; final rating by measurements
Branch fuse and holder | 4 | 60 | 240 | Initial 2 A time-delay per servo; verify ratings
USB-C data cable | 1 | 100 | 100 | Computer setup; reuse if available
Copper wire and DC input socket assortment | 1 | 300 | 300 | Rated soldered harness; include a socket matching the motor adapter plug
Perfboard and heat-shrink assortment | 1 | 100 | 100 | Insulated sensor/driver assembly and joints

Budget item | Amount
Installed electronics allowance | ₹5,594
Delivery allowance | ₹500–1,000
Spares, pack quantities and price variation reserve | ₹1,000
Combined planning range | ₹7,094–7,594
Practical electronics budget | About ₹7,500–8,000

Printing, mechanical hardware, cleanable liner, tools, laptop and labour are excluded. A reliable total build price requires a print quote and a finalized mechanical assembly. The exact stop contact is not selected; ₹1,000 is a placeholder, not proof that a suitable rated part is available at that price.

## Low cost choices without changing the objective

Reuse a compatible owned UNO R4 (₹1,000 allowance saved) and a suitable data cable (₹100 saved). Use the college printer and test instruments when available. Fit one container first to avoid four failed prints. Keep the current LCD, buzzer and refill LEDs: the LED addition is only ₹28; its four resistors are already included above.

Do not omit the RTC, optical counters, stop, cover interlock, current-limiting resistors or required power protection to meet this budget. The current design depends on them. Reusing a part avoids purchasing it; it does not remove its function.

# Assembly instructions and common mistakes

1. Measure the actual servo, horn, LCD, UNO, switch and adapter plugs. Record their dimensions before modifying the candidate CAD.

2. Build one empty bowl/rotor assembly. Confirm smooth motion, retained hardware and closure without power. Adapt its motor mount to the purchased servo; do not force an incompatible horn.

3. Fit one optical channel around its outlet. Check clear/blocked logic with motor power disconnected. Add light shielding and accessible insulated test pads.

4. Validate the first mechanism with inert test pieces before repeating it for the other three containers.

5. Fit four labelled fill ports and caps, a shared guard and the cover switch. Confirm each port opens into only its intended container. Check finger, wire and cap clearance.

6. Mount the fixed tray and liner under every outlet. Fit controller/LCD plates on insulated standoffs and mount the four labelled LEDs on fixed tabs.

7. Assemble the logic circuits on perfboard. Inspect polarity and resistor values, then continuity-test the ground and power rails before applying logic power.

8. Wire the fused motor distribution and two-contact stop. Leave motor positives disconnected while uploading factory firmware and checking all logic inputs.

9. Connect one fused motor branch for empty calibration, then add the remaining branches after measured acceptance. Route motor returns away from sensor wiring.

10. Complete the tests on page 12 and retain the measurement record with the project.

## Mistakes most likely to cause failure

Mistake | Prevention
Printing everything before a fit check | Print one mount/rotor and fit coupons first; revise the dimensions from measurements.
Leaving raw optics on A0–A3 | Move them to Schmitt inputs/test pads; these UNO pins now drive LEDs.
Using a chargeable RTC board with CR2032 | Choose a non-charging breakout or a properly documented compatible battery arrangement.
Treating NO/NC labels as installed behaviour | Measure continuity with the cover fitted and removed, and with the stop released and pressed.
Relying on servo detachment to close the outlet | Verify mechanical closure after power is removed; redesign a gate that drifts open.
Changing a fuse to stop nuisance trips | Measure current and find the cause before changing ratings; protect the weakest wiring/contact.

# Firmware and computer setup

## Install the firmware

1. Install Arduino Renesas UNO board package 1.6.0. Select the actual UNO R4 Minima or UNO R4 WiFi board and USB port.

2. Install Servo 1.3.0, RTClib 2.1.4, Adafruit BusIO 1.17.4, ArduinoJson 7.4.3 and hd44780 1.3.2. The pinned list is firmware/libraries.txt.

3. Open firmware/SmartPillBudget/SmartPillBudget.ino. Confirm the LCD I2C address in config.h; 0x27 is a default, and some backpacks use 0x3F.

4. Leave HARDWARE_COMMISSIONED=false for initial upload. OPEN_US/CLOSED_US and the 300 µs beam filter are starting values, not calibration results.

5. Complete logic checks and empty servo calibration. Set proven pulse/filter values. Enable HARDWARE_COMMISSIONED only for the supervised inert-object acceptance phase; distribute uncommissioned builds with it false.

## Install and use the simple Windows app

1. Install Python 3 with Tcl/Tk. Run Setup.bat to install pyserial 3.5, then Start.bat.

2. Choose the COM port and connect. The app checks SmartPillBudget protocol 4, then reads the device settings. Close Serial Monitor first so it does not own the same port.

3. Check the computer’s local date/time, then click Set clock. The device stores local wall time; Chennai should use IST. There is no automatic network time correction.

4. Enter four labels of at most 16 plain ASCII characters, three distinct HH:MM times and whole-piece counts 0–10. Check “Enable saved daily schedule” when ready.

5. Click Save to dispenser and wait for “Device settings verified.” An acknowledgement alone is insufficient. Manual dosing and refill selection wait for settings readback. If values differ, read and review them before proceeding.

6. After commissioning, use Enable controls. Test a future automatic period with USB disconnected while both external supplies remain on.

## Manual controls and records

The period selector chooses which saved quantities an extra manual dose uses. Confirm that the tray is empty. A USB failure leaves the outcome uncertain; the app never automatically retries the dose. Inspect the device before another command.

Connected result snapshots go to data/events.jsonl. Matching uploaded settings are copied to data/last_uploaded.json. These are convenience files, not a complete offline history. A board boot or reconnect triggers fresh identification/readback; local unsaved edits are not an authoritative device record.

# Commissioning and acceptance checklist

Record actual measurements and pass/fail results. Host tests cannot substitute for these checks. Begin with empty mechanics, then use inert pieces matching the test profiles.

Test | Required observation or record
Power and wiring | Correct polarity, common ground, separate positive rails, matched input socket, rated stop contacts and insulated joints. Record voltage, current, drop and temperature.
Optics without motors | All four channels clear HIGH / blocked LOW. Capture shortest valid pulses and interference while LCD, USB and buzzer are active.
Empty servo calibration | One branch at a time. Find travel without hitting stops; record horn alignment, closed/open pulse widths and reliable power-off closure.
Counting trials | Test each profile at low/full fill, counts 1 and 10, then multi-container doses. Compare physical pieces with events. Any unresolved double feed, missed count or jam fails acceptance.
Cover and stop | Opening cover during dispensing/closing faults. Physical stop removes motor voltage independently of software. Broken sense wires inhibit operation.
Refill LEDs | Select 1–4 repeatedly; exactly one lights and matches the labelled port/LCD. Finish requires closed cover. USB/heartbeat loss clears lights within five seconds.
Schedules and transitions | Test offline start, reboot in the due minute, same-date duplicate prevention, startup near due time, busy/refill completion within the due minute and skipped late periods.
Power interruption | Cut power before/during claim, active-marker write, motion, closing and completion. Repeat across journal pages. No uninspected resume or automatic redispense.
Fault handling | Blocked beam, no pieces, excess events, unplugged RTC/LCD, manual USB loss and storage failure must inhibit motion and require inspection.
Desktop readback | Save changed quantities, delay readback, reconnect and reset the board. Manual/refill must not use stale settings. Wrong protocol is rejected.

## Guarded empty bench command

With factory commissioning flag false, empty mechanism, closed cover and released stop, use Serial Monitor at 115200 baud with newline. Send a ping, then the following example. The servo attaches for 500 ms. Adjust only in small measured increments within its safe mechanical travel.

{"cmd":"bench","container":1,"us":1500,"confirm":"EMPTY"}

Record per container: L/W/T of pieces, servo model, mounting dimensions, horn index, pulse limits, beam levels, minimum pulse, maximum current, fill level, trial count, miscounts, jams and corrective actions. See docs/ACCEPTANCE_TESTS.md for the expanded campaign.

# Fault handling and troubleshooting

## Recovery sequence

1. Use the physical stop if there is unexpected motion or dispensing. It is the hardware motor-power interruption.

2. Inspect and empty the tray, chute and outlets. Remove all partial or extra doses and resolve the jam or electrical fault. Do not assume a stopped servo has closed the gate.

3. Close the cover and release the stop. Connect the computer, read the fault and verify the clock.

4. Choose Clear fault after inspection. Already-due periods are consumed for today so recovery does not catch them up. Controls remain disabled until Enable controls is used.

5. Run a supervised inert-object check before returning the prototype to operation. Never automatically retry an uncertain dose.

Symptom | Check first
LCD blank or I2C fault | Supply, ground, contrast, SDA/SCL and actual backpack address. The purchased controller must be compatible with the library.
Controls refuse to enable | Factory commissioning flag, valid RTC/storage, cover stable for one second, released stop, no active fault and healthy hardware initialization.
Pill timeout or jam | Empty or bridging hopper, insufficient torque, blocked gate, misaligned optics or filter too long. Do not raise timeouts before investigating.
Extra/unexpected outlet event | Double feed, pieces falling during closure, light interference, electrical noise or unintended activity in another container.
LED wrong or multiple LEDs lit | A0–A3 mapping, one resistor per LED, shared wiring errors and physical label mismatch. Software permits only one selection.
LED off after USB loss | Expected. Reconnect and select again; an open cover must still inhibit motion.
No automatic dose after missed time | Expected no-catch-up behaviour. Review the latest outcome; any manual request is a separate extra dose.
Restart or storage fault | Inspect for an unfinished dose. Normal clear can repair damaged pages only when a valid snapshot remains.

## Storage reset is a last resort

If all snapshots are invalid, ordinary clear cannot reconstruct settings or day claims. Use firmware/ResetStorage only on an inspected empty bench with motor power disconnected, stop sense open and valid RTC. Send RESET_EMPTY as documented in that sketch, then upload the operating firmware and reconfigure. The reset discards prior history/settings and skips all periods for the current day.

# Audit findings and verification results

This audit found and corrected the following defects in the current source. It does not establish that every possible fault has been eliminated.

Issue found | Correction
Due period consumed before startup enabling | Scheduler and manual start wait for startup checks to settle.
Busy period could run later in the same minute | Remember due periods without flash writes during motion; claim them as missed afterwards. Capture completion and refill-exit boundaries too.
Stale idle/refill optical pulses caused false faults | Start each job with a fresh pending-pulse boundary; active-job unexpected events still fault.
Cover/stop could change during pre-motor storage | Recheck both at actual servo attachment.
A missed period overwrote interrupted-job evidence | Advance missed claims while preserving active/fault outcomes.
Acknowledgement allowed stale configuration use | Invalidate cached settings on upload; keep manual/refill gated until device readback.
Reset board retained desktop identity/settings | Reidentify firmware and retrieve settings on a boot event.
Old log sequence suppressed later connection results | Reset the sequence tracker on disconnect.
Piezo driver lacked a discharge path | Add a separate 1 kΩ resistor across the piezo terminals; update wiring and cost. Sound still needs a bench test.

## Checks actually passed

- Operating and ResetStorage sketches compile/link for UNO R4 Minima and UNO R4 WiFi with the official core/compiler recipes. Separate commissioned copies also compile; shipped configuration remains false.
- Actual-sketch host tests cover offline scheduling, duplicate prevention, motion/closing, stop/cover, refill LEDs, USB timeout, storage failure and the new scheduling/interlock regressions.
- Journal tests cover truncated completion writes after erase, rotation, recovery, date claims and invalid settings. Beam tests cover filtering, duplicate edges, rollover and saturation.
- Ten Python tests pass, including seven real Tk widget tests. Eight new STL templates pass mesh closure/orientation/volume checks.

Factory operating build sizes: Minima .text 91,132 bytes and .data+.bss 8,296; WiFi .text 94,644 and .data+.bss 11,828. These are section sizes, not maximum runtime memory. The local Arduino CLI discovery issue required invoking official compile/link recipes directly; a successful Arduino CLI invocation is not claimed.

Outstanding: physical fit, single-piece separation, closed-gate retention, optics under real motion, 5 V servo torque/current, final fuse/stop selection, power-cut tests, contact-material suitability and endurance. Full evidence and limitations are in VALIDATION.md and docs/AUDIT.md.

# Project files references and handover

Location inside the project | Purpose
firmware/SmartPillBudget | Current operating sketch, pin configuration, beam counter and storage journal.
firmware/ResetStorage | Explicit destructive empty-bench recovery utility; not normal operation.
desktop; Setup.bat; Start.bat | Simple wired app, input validation and Windows launch scripts.
docs; VALIDATION.md | Detailed wiring, costs, refill, build, acceptance tests and audit evidence.
mechanical/budget_candidates | Eight new editable STL/SCAD templates; print-four parts are named accordingly.
mechanical/reference_parts; original_sources; pill_candidates | Original STEP/extracted references and experimental profile parts. Do not assume every reference part is needed.
tests; validation; SHA256SUMS.txt | Regression sources, compiler section reports and package integrity manifest.

## Price references and engineering sources

Web spot-checks on 9 October 2026 showed ₹126 for LCD-only, ₹45 for an I2C backpack and ₹849 for the example 5 V/5 A adapter. The ₹250 LCD-plus-backpack and ₹900 motor-supply rows remain rounded allowances. Other shopping rows are estimates; compare the exact variant, GST, delivery, pack quantity and return policy before ordering.

Original Smart Pill Dispenser project by Makers UPV (https://www.hackster.io/makersupv/smart-pill-dispenser-07a43f)

Arduino UNO R4 Minima pinout and GPIO limits (https://docs.arduino.cc/resources/pinouts/ABX00080-full-pinout.pdf)

Arduino UNO R4 Minima datasheet (https://docs.arduino.cc/resources/datasheets/ABX00080-datasheet.pdf)

Murata piezo transistor drive and discharge resistor guidance (https://www.murata.com/en-global/support/faqs/sound/diaphragm/char/sch0001)

Robocraze 16 by 2 LCD price reference (https://robocraze.com/products/16x2-lcd-module-green)

Robocraze I2C backpack price reference (https://robocraze.com/products/16x2-lcd-i2c-interface-adapter)

Robu enclosed adapter price references (https://robu.in/product-category/power-supply-adapter/)

Keep ATTRIBUTION.md with the original/adapted mechanical material. The original project is the reference for the mechanical concept; it does not validate the changed budget electronics, software or adapted mounts.

## Practical handover for three beginners

Assign one person to wiring/power, one to firmware/app setup, and one to mechanical fit and trial records. Cross-check each other’s work. Plan roughly four to eight weeks part time for procurement, one-container iteration, integration and repeat testing; failed prints or unreliable separation can extend this. This is an estimate, not a tested build duration.

The next physical milestone is one reliable, measured container with a closed gate, clean optical counts and a working stop. Repeat that proven assembly for the other three before attempting the full schedule demonstration.

9 October 2026 • Page

SMARTPILL / UNO R4 / WIRED BUDGET EDITION
