Tejesh-ECM/Automated-Pill-Dispenser/validation/MINIMA_SmartPillBudgetCommissioned_sections.txt

C:\Users\user\Documents\Codex\2026-10-06\https-www-hackster-io-makersupv-smart\work\budget_build\MINIMA\SmartPillBudgetCommissioned.elf  :
section                    size         addr
.text                     91132        16384
.ARM.exidx                    8       107516
.fsp_dtc_vector_table         0    536870912
.data                       700    536870912
.noinit                      28    536871612
.bss                       7596    536871640
.heap                      8192    536879240
.stack_dummy               1024    536902400
.vector_table               256    536903424
.data_flash                   0   1074790400
.id_code                     28     16842776
.option_setting               0            0
.option_setting_ns            0            0
.option_setting_s             0            0
.ARM.attributes              48            0
.comment                    199            0
.debug_info             3253401            0
.debug_abbrev            123215            0
.debug_loc               219710            0
.debug_aranges            10024            0
.debug_ranges             40160            0
.debug_macro             176493            0
.debug_line              364782            0
.debug_str               740742            0
.debug_frame              32640            0
.stab                        48            0
.stabstr                    441            0
Total                   5070867
