Tejesh-ECM/Automated-Pill-Dispenser/validation/UNOWIFIR4_SmartPillBudgetCommissioned_sections.txt

C:\Users\user\Documents\Codex\2026-10-06\https-www-hackster-io-makersupv-smart\work\budget_build\UNOWIFIR4\SmartPillBudgetCommissioned.elf  :
section                    size         addr
.text                     94668        16384
.ARM.exidx                    8       111052
.fsp_dtc_vector_table         0    536870912
.data                       688    536870912
.noinit                      24    536871600
.bss                      11140    536871624
.heap                      8192    536882768
.stack_dummy               1024    536902400
.vector_table               256    536903424
.data_flash                   0   1074790400
.id_code                     28     16842776
.option_setting               0            0
.option_setting_ns            0            0
.option_setting_s             0            0
.ARM.attributes              48            0
.comment                    199            0
.debug_info             3383599            0
.debug_abbrev            128151            0
.debug_loc               220982            0
.debug_aranges            10200            0
.debug_ranges             40328            0
.debug_macro             192463            0
.debug_line              382366            0
.debug_str               742910            0
.debug_frame              34328            0
.stab                       180            0
.stabstr                    387            0
Total                   5252169
