Tejesh-ECM/Automated-Pill-Dispenser/(commit log)

2026-10-10 Add complete pill dispenser project
    Publish the current UNO R4 budget revision with 130 files preserved inside the ZIP, plus standalone documentation and archive checksum. Runtime schedules, event logs, caches and temporary files are excluded.
2026-10-11 Replace project archive with browsable source folders
    [C1_small_round_clearance_coupon.step, C1_small_round_clearance_coupon.stl, C1_small_round_dummy.step, C1_small_round_dummy.stl, C1_small_round_rotor.step, C1_small_round_rotor.stl, C2_large_round_clearance_coupon.step, C2_large_round_clearance_coupon.stl]
